LucasDachman/greenhouse/src/main.ino

#include "arduino_secrets.h"
#include "globals.h"
#include "targets.h"
#include "pin_defs.h"
#include <SPI.h>
#include <WiFiNINA.h>
#include "SmoothingFilter.h"
#include "Logger.h"
#include <time.h>
#include "SensorReader.h"
#include <ArduinoJson.h>
#include <arduino-timer.h>
#include <WDTZero.h>
#include "helpers/LogHelpers.hpp"
#include <Actuator.hpp>
#include "strategies/FanStrategy.hpp"
#include "strategies/MisterStrategy.hpp"
#include "strategies/PumpStrategy.hpp"
#include "helpers/LedHelpers.hpp"

// WiFi credentials.
char ssid[] = WIFI_SSID;
char pass[] = WIFI_PASS;

int oneSec = 1000L;
int oneMin = oneSec * 60;
int tenMin = 10 * oneMin;

WDTZero watchdog;

auto timer = Timer<
    10,     /* max tasks */
    millis, /* time function for timer */
    void *  /* handler argument type */
    >();

SensorReader sensors;

FanStrategy fanStrategy;
Actuator<int> fan(FAN_1, fanStrategy);

MisterStrategy misterStrategy;
Actuator<int> mister(MISTER, misterStrategy);

PumpStrategy pumpStrategy(0);
Actuator<PumpStrategyParams> pump_1(PUMP_1, pumpStrategy);

extern "C" char *sbrk(int incr);

int freeMemory()
{
  char stack_dummy = 0;
  return &stack_dummy - sbrk(0);
}

unsigned long getTime()
{
  return WiFi.getTime();
}

void onShutdown()
{
  Serial.println("Shutting down...");
}

bool sendData(void *)
{
  Serial.println("sendData");
  sensors.heaterBurst();
  delay(1000);
  sensors.updateAll();

  JsonDocument doc;
  doc["temp"] = sensors.getTemperature();
  doc["hum"] = sensors.getHumidity();
  for (int i = 0; i < NUM_SOIL_SENSORS; i++)
  {
    doc[SOIL_KEYS[i]] = sensors.getSoilDryness(i);
  }
  doc.shrinkToFit();

  logger.build()
      .cloud(true)
      .topic("greenhouse/data/env")
      .data(doc)
      .log();
  return true;
}

void sendData()
{
  sendData(nullptr);
}

bool waterIfNeeded(void *)
{
  sensors.updateSoilDryness();
  PumpStrategyParams params;
  sensors.getSoilDryness(params.values);
  params.start = 1;
  params.end = 3;
  pump_1.respondTo(params);
  return true;
}

bool humidifyIfNeeded(void *)
{
  sensors.updateHumidity();
  mister.respondTo(sensors.getHumidity());
  return true;
}

bool fanIfNeeded(void *)
{
  // if (mister.isOn()) {
  //   if (fan.isOn()) {
  //     fan.stop();
  //   }
  //   return true;
  // }
  sensors.updateTemperature();
  fan.respondTo(sensors.getTemperature());
  return true;
}

void checkBtn()
{
  if (digitalRead(BTN_1) == LOW)
  {
    delay(500);
    if (digitalRead(BTN_1) == LOW)
    {
      Serial.println("Button held down!");
      pump_1.start();
      delay(3000);
      pump_1.stop();
    } else {
      Serial.println("Button pressed!");
      sensors.updateAll();
      sensors.printAll();
      sendData();
    }
  }
}

bool healthBlink(void *)
{
  // static bool led_on = false;
  // carrier.leds.setPixelColor(0, 0, 255, 0);
  // if (led_on)
  // {
  //   led_on = false;
  //   carrier.leds.setBrightness(50);
  // }
  // else
  // {
  //   carrier.leds.setBrightness(0);
  //   led_on = true;
  // }
  // carrier.leds.show();
  // return true;
}

void setupTime()
{
  unsigned long epoch = 0;
  int retries = 0;
  while ((epoch = WiFi.getTime()) == 0 && retries < 10)
  {
    Serial.println("Waiting for NTP time...");
    delay(1000);
    retries++;
  }

  if (epoch == 0)
  {
    Serial.println("Failed to retrieve time from NTP server.");
    InternalLed::red();
    while (1)
      ;
  }

  Serial.print("Epoch time: ");
  Serial.println(epoch);
}

void setupWiFi()
{
  Serial.println("Connecting to WiFi...");
  InternalLed::blue();
  WiFi.begin(ssid, pass);
  while (WiFi.status() != WL_CONNECTED)
  {
    Serial.println(WiFi.status());
    delay(1000);
  }
  Serial.println("Connected.");
}

bool reconnectWiFi(void *)
{
  switch (WiFi.status())
  {
  case WL_CONNECT_FAILED:
  case WL_CONNECTION_LOST:
  case WL_DISCONNECTED:
    setupWiFi();
    return true;
  }
  return false;
}

void setup()
{
  InternalLed::setup();
  InternalLed::white();

  // Debug console
  Serial.begin(115200);
  while (!Serial && millis() < 5000)
  {
    // Wait for Serial Monitor to connect (max 5 seconds)
  }

  Serial.println("Starting watchdog...");
  watchdog.attachShutdown(onShutdown);
  watchdog.setup(WDT_SOFTCYCLE4M);

  if (!ECCX08.begin())
  {
    Serial.println("No ECCX08 present!");
    InternalLed::red();
    while (1)
      ;
  }
  sslClient.setEccSlot(0, awsIotCertificatePemCrt);

  Serial.println("Setting up sensors...");
  sensors.setup();

  pinMode(BTN_1, INPUT_PULLUP);

  setupWiFi();

  InternalLed::purple();
  setupTime();
  ArduinoBearSSL.onGetTime(getTime);

  timer.every(tenMin, sendData);
  timer.every(5 * oneMin, waterIfNeeded);
  timer.every(oneSec, fanIfNeeded);
  timer.every(oneSec, humidifyIfNeeded);
  timer.every(30 * oneSec, reconnectWiFi);
  // timer.every(5 * oneSec, [](void *) -> bool
  //             { sensors.updateAll(); sensors.printAll(); return true; });
  // timer.every(250, healthBlink);

  InternalLed::green();

  logger.build()
      .serial(true)
      .cloud(true)
      .data("Setup complete")
      .log();

  // sendData();
}

void loop()
{
  watchdog.clear();
  timer.tick();
  awsIotMqttClient.loop();
  checkBtn();
}
