LucasDachman/greenhouse/src/Logger.h

#ifndef LOGGER_H
#define LOGGER_H

#include <Arduino.h>
#include <ArduinoJson.h>
#include "arduino_secrets.h"
#include "AwsIotMqttClient.h"

class LogParamsBuilder;

class Logger
{
public:
  struct LogParams
  {
    bool serial = false;
    bool notification = false;
    bool cloud = false;
    const char *topic = "greenhouse/logs/mkrwifi1010";
    JsonDocument doc;
  };

  Logger(Stream &stream, AwsIotMqttClient &awsIotMqttClient);

  void log(const LogParams &params);

  LogParamsBuilder build();

  Stream *stream;
  AwsIotMqttClient *mqttClient = nullptr;
};

class LogParamsBuilder
{
private:
  Logger::LogParams params;
  Logger *logger;

public:
  LogParamsBuilder(Logger *logger);

  LogParamsBuilder &serial(bool serial);

  LogParamsBuilder &notification(bool notification);

  LogParamsBuilder &cloud(bool cloud_log);

  LogParamsBuilder &topic(const char *topic);

  LogParamsBuilder &data(const char *data);

  LogParamsBuilder &data(String &data);

  LogParamsBuilder &data(int data);

  LogParamsBuilder &data(JsonVariant data);

  LogParamsBuilder &dataf(const char *format, ...);

  Logger::LogParams build();

  void log();
};

#endif // LOGGER_H
