LucasDachman/greenhouse/(commit log)

2025-05-06 implement SensorReader
2025-05-07 Add humidity timer
2025-05-08 Fix pins a soil sensor reading
    [SensorReader.cpp, pin_defs.h]
2025-05-08 add additional virtual pins for sensors
2025-05-09 Fix pin modes/nums
2025-05-09 led stuff
2025-05-11 Update pump logic
2025-05-11 LED file
2025-05-15 Add smoothing to soil sensor readings
2025-05-15 Fix sensor index
2025-05-15 Break actuator logic out into strategies
2025-05-15 Optimize timer
2025-05-20 Refactor soil reading and leds
2025-05-26 update watering sensors
